Mohitpatel9999/Dual-H-Bridge-Arduino-Shield-/Pictures/3d bottom.PNG

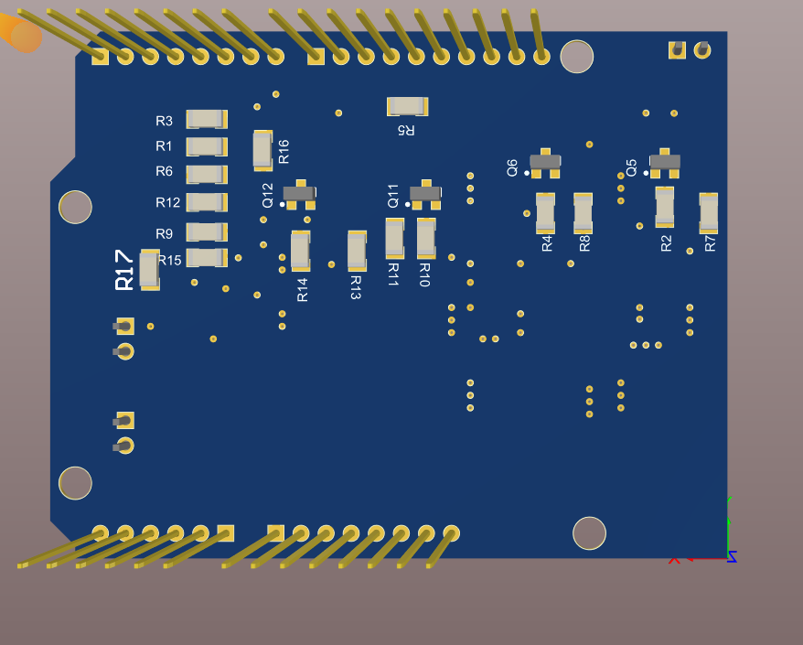
Pictures/3d bottom.PNG
