Mohitpatel9999/Dual-H-Bridge-Arduino-Shield-/Pictures/3d top.PNG

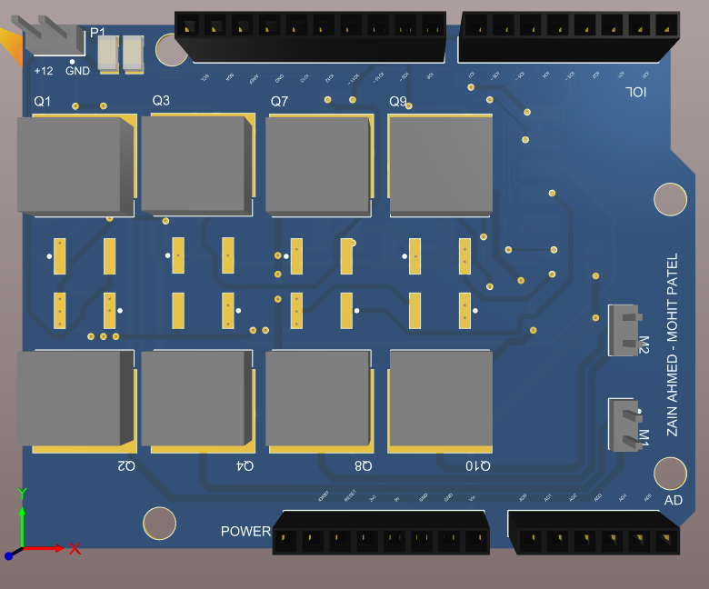
Pictures/3d top.PNG
