Mohitpatel9999/Dual-H-Bridge-Arduino-Shield-/Pictures/asembly view.PNG

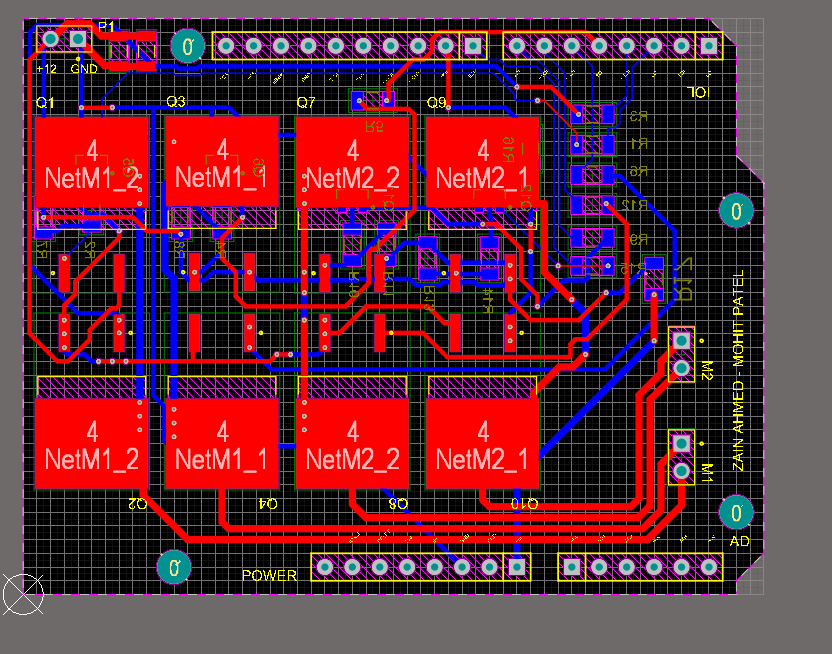
Pictures/asembly view.PNG
