Mohitpatel9999/Dual-H-Bridge-Arduino-Shield-/Pictures/signal layers.PNG

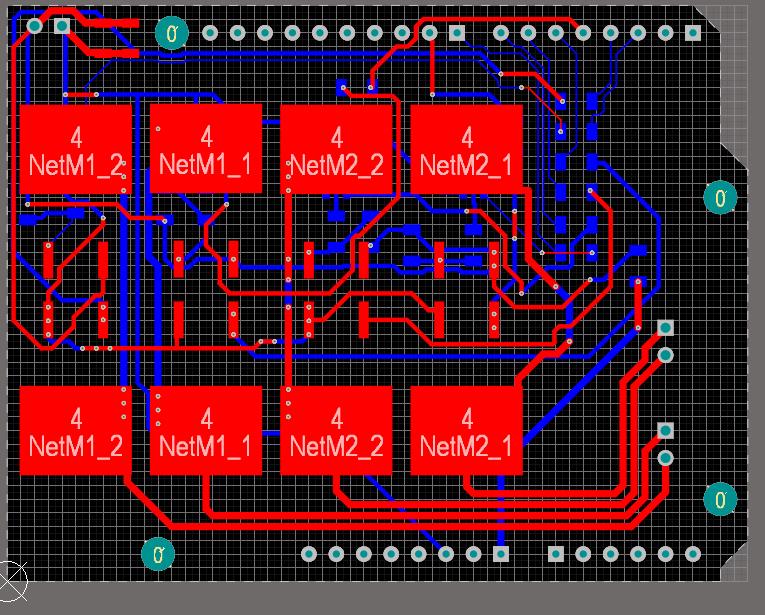
Pictures/signal layers.PNG
