Mohitpatel9999/Dual-H-Bridge-Arduino-Shield-/Schematic/ArduinoUnoShield.pdf

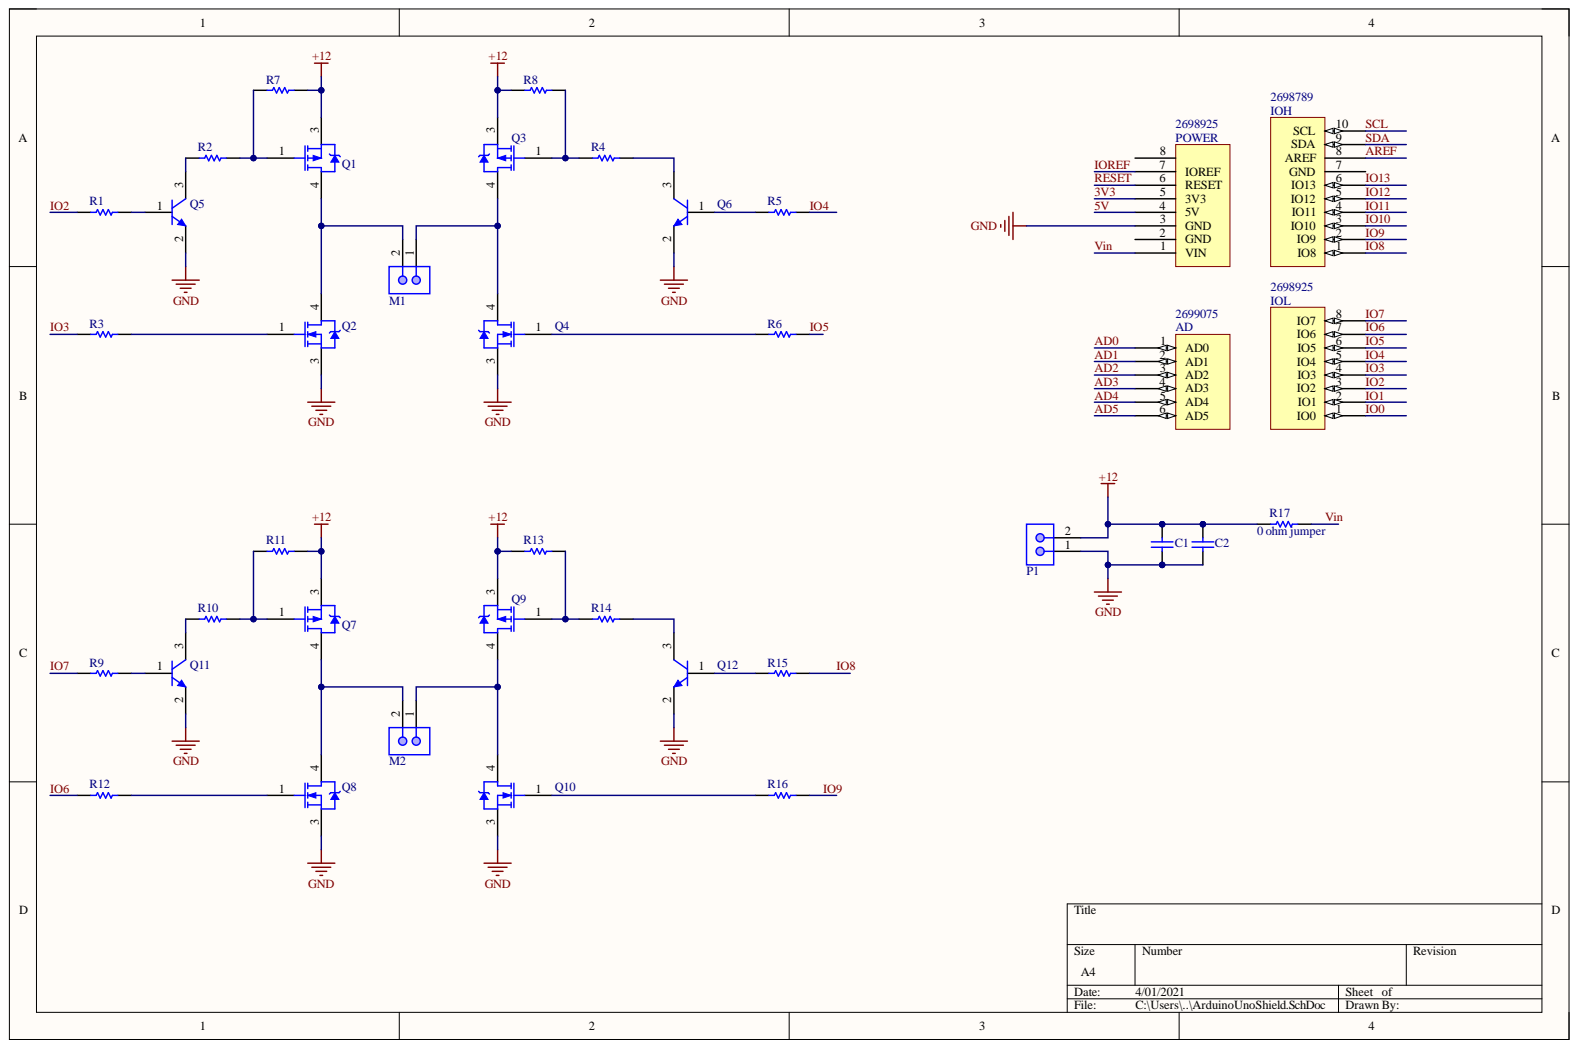
[picture p14: page 1]

Siz e A4 | Numb e r | R evisio n

Da te : 4/01/202 1 | She et of
File : C:\Use rs\. .\ArduinoUnoShie l d . S c hD o c | Dr awn By:
