Mohitpatel9999/Dual-H-Bridge-Arduino-Shield-/(list of files, drawings)

Other design files:
AltiumArduinoR3_UNOSheild/AltiumArduinoR3_UNOSheild/ArduinoUnoSheild.PrjPcb
AltiumArduinoR3_UNOSheild/AltiumArduinoR3_UNOSheild/ArduinoUnoShield.PcbDoc
AltiumArduinoR3_UNOSheild/AltiumArduinoR3_UNOSheild/ArduinoUnoShield.SchDoc
AltiumArduinoR3_UNOSheild/AltiumArduinoR3_UNOSheild/Header.PcbLib
AltiumArduinoR3_UNOSheild/AltiumArduinoR3_UNOSheild/Header.SchLib
